nayeli-guzman/safecane/modelo3d/salida/safecane.step

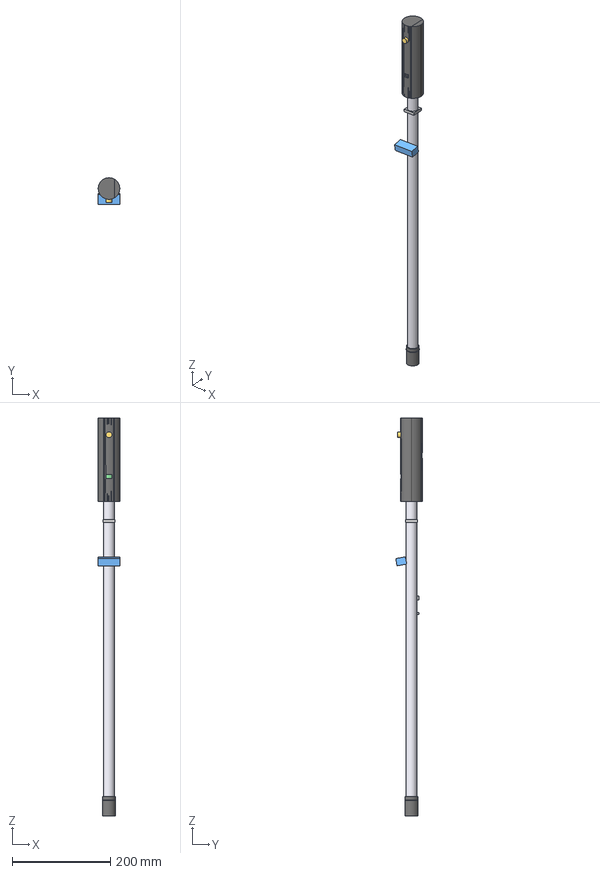
[picture p1: CAD file, 2026-11-06]
modelo3d/salida/safecane.step
45.0 x 54.0 x 810.0 mm
mango_a
mango_b
tubo
contera
esp32
bateria
tp4056
mt3608
mpu6050
tcrt5000
pulsador
hcsr04
led
ldr
gps
piezo
