nayeli-guzman/safecane/modelo3d/salida/mango_b.stl

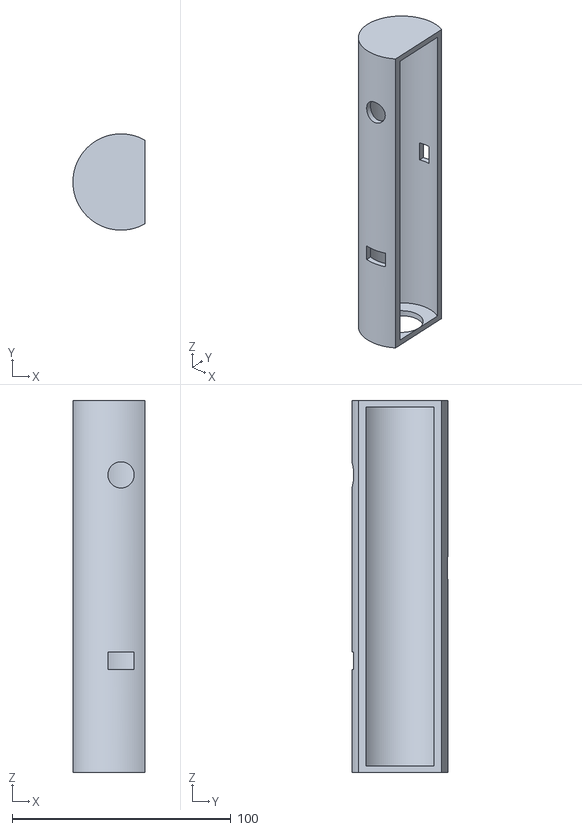
[picture p2: CAD file, 2026-11-06]
modelo3d/salida/mango_b.stl
33.0 x 44.0 x 170.0
