nayeli-guzman/safecane/modelo3d/salida/contera.stl

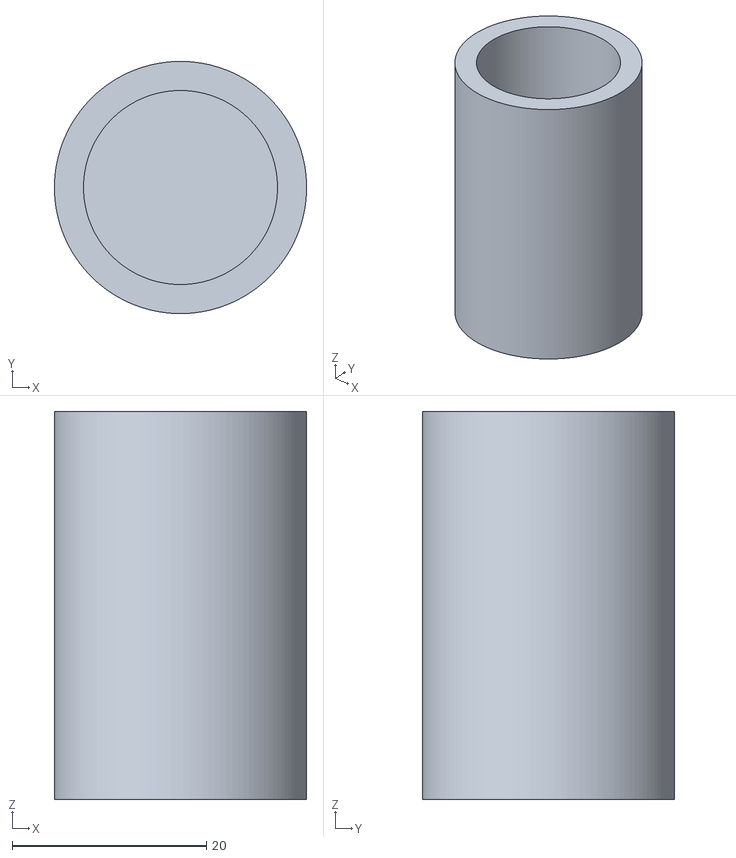
[picture p3: CAD file, 2026-11-06]
modelo3d/salida/contera.stl
26.0 x 26.0 x 40.0
