nayeli-guzman/safecane/(list of files, cad)

Other CAD files:
modelo3d/salida/mango_a.stl
