nayeli-guzman/safecane/(commit log)

2026-10-29 add: modelo 3D paramétrico (CadQuery) y visor interactivo three.js
    [contera.stl, mango_a.stl, mango_b.stl, safecane.step]
2026-10-29 docs: ejecución rápida del modelo 3D en el README
2026-11-06 fix: abrir el tablero en la raíz de Vercel
